cmcpartland/PID-Temperature-Controller/PID_Temperature_Controller/Pythics Gui/PID Temperature Controller/PID Temperature Controller.pdf

# PID Temperature Controller

## Arduino

- Measures temperature using thermistor
- Controls power going to heating/cooling unit (Thermo-electric cooler, TEC)
- Only variable output from Arduino is PWM signal

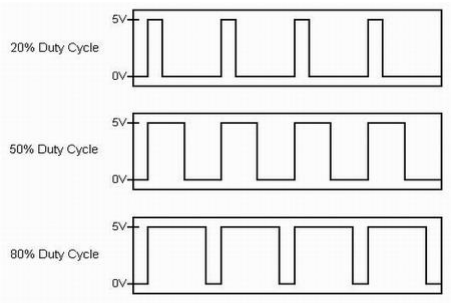
[picture p3: figure]

- Duty cycle is controllable:
- PWM:(0, 255) ⟶ Duty Cycle: (0,100)

## Circuit

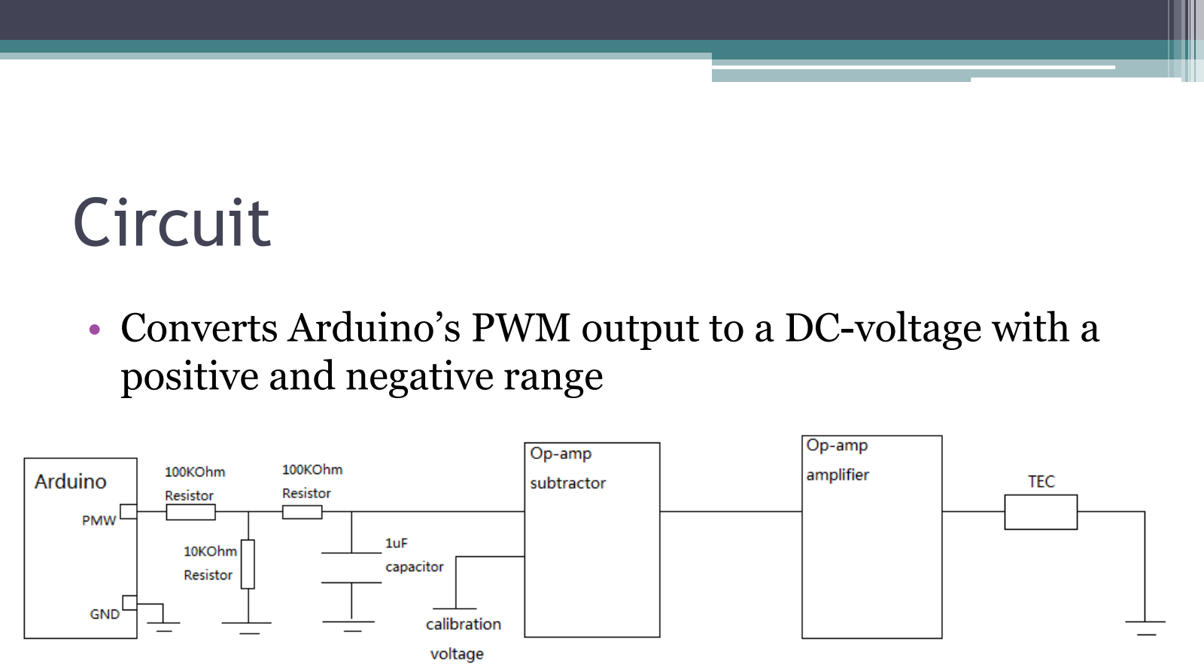
[picture p4: page 3]

- Converts Arduino’s PWM output to a DC-voltage with a positive and negative range
- Provides power for the TEC

## PID Algorithm

- Continuous:
- PWM = P ∗ error + I ∗ error dt t
0

+ D ∗

d error
dt
- Discrete:
- PWM = P ∗ error + I ∗ error ∗ Δ t + D ∗

Δerror
Δt
- Improvements:
- Handles integral windup
- Handles on-the-fly parameter changes (I term)
- Handles derivative-kick

↓ Arduino measures temperature from thermistor

↓ PID algorithm determines PWM output value

↓PWM signal converted to DC-voltage signal

↓DC-voltage signal used to power TEC

## Control Flow

## Practical Issues

- Power provided to TEC is not exactly symmetric with Arduino’s PWM output
- The larger the range, the more asymmetric the output
- Range must be large enough to properly power TEC
- Choosing a range:
- Choose a PWM range, i.e. 80 to 120
- Change calibration voltage until midpoint (PWM=100) gives 0 V output
- Make sure DC-voltage signal is symmetric,
- i.e. PWM=80 gives – 1.3 V, PWM = 120 gives 1.3 V
- Determined range: PWM: (80, 220)
- Low-end of range uses more power than high-end of range
- i.e., PWM=80 draws 1.25 A from power supply, PWM=220 draws 0.93 A

## Practical Issues (contd)

- TEC needs a good heatsink to efficiently heat and cool
- Solution:

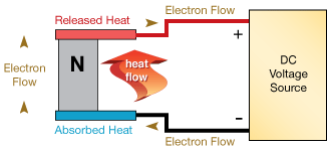
[picture p5: figure]

- Attach second TEC to open side of main TEC

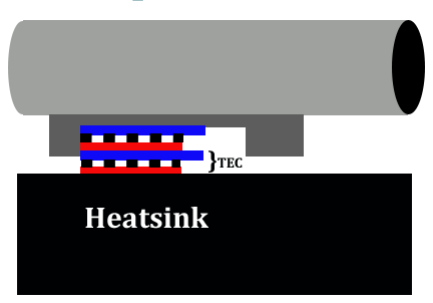
[picture p6: figure]

## Practical Issues (contd)

- Accuracy of Arduino gives error of temperature measurements: ± 0.02° C
- Measurements fall into bins of width ~0.04° C

## Temperature Controller User Interface

- Created in Pythics
- Functionality:
- Plot temperature over time
- Change parameters: P, I, D, and set-temperature
- Save parameters to Arduino’s memory

## Results

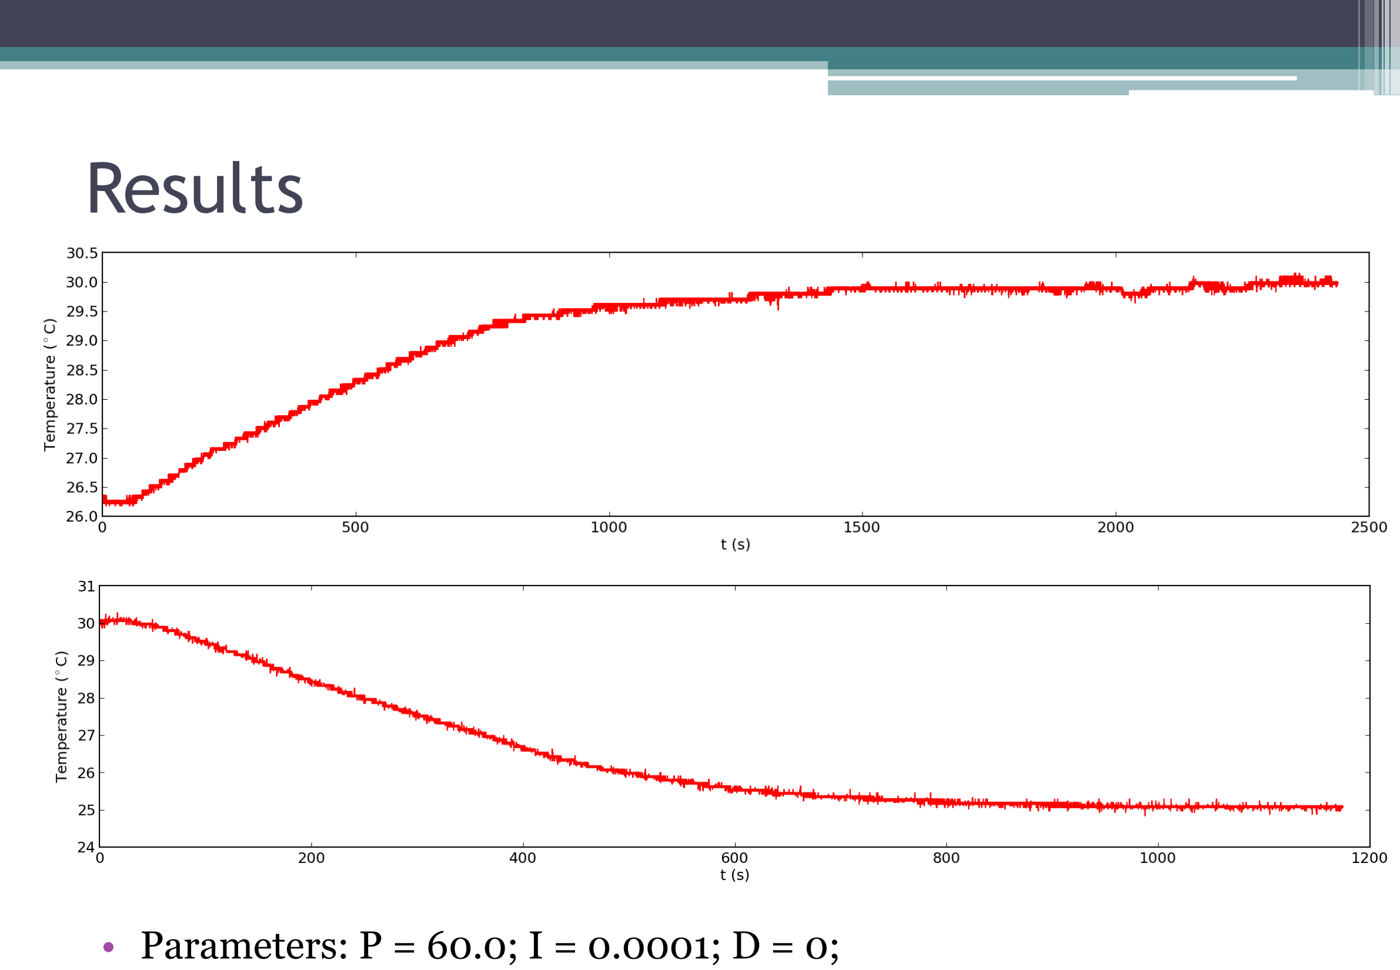
[picture p7: page 10]

- Parameters: P = 60.0; I = 0.0001; D = 0;

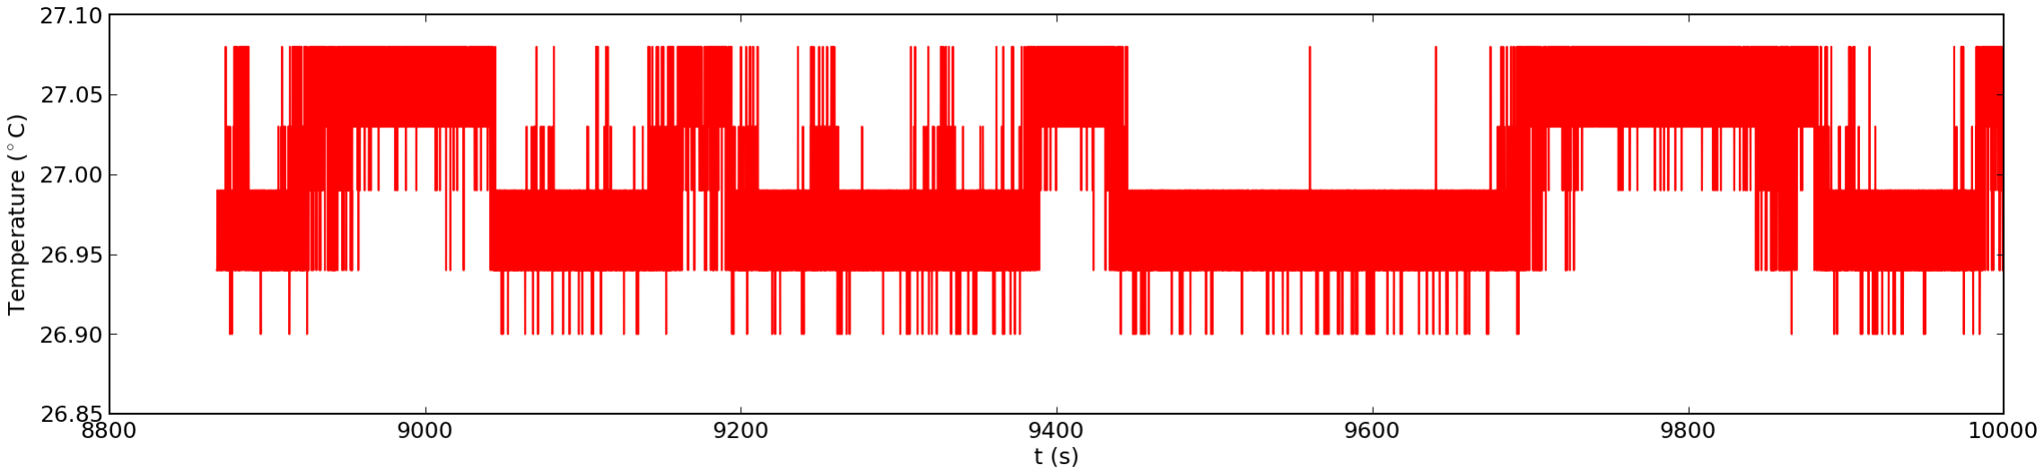
[picture p8: figure]
