cmcpartland/PID-Temperature-Controller/PID_Temperature_Controller/Pythics Gui/PID Temperature Controller/Images/device picture.jpg

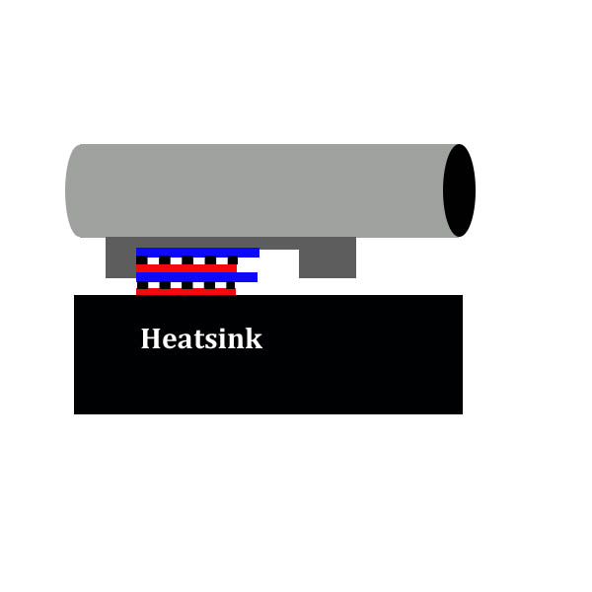
PID_Temperature_Controller/Pythics Gui/PID Temperature Controller/Images/device picture.jpg
