cmcpartland/PID-Temperature-Controller/PID_Temperature_Controller/Pythics Gui/PID Temperature Controller/Images/device picture.png

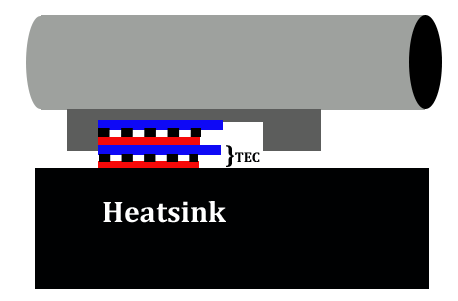
PID_Temperature_Controller/Pythics Gui/PID Temperature Controller/Images/device picture.png
