cmcpartland/PID-Temperature-Controller/PID_Temperature_Controller/Pythics Gui/PID Temperature Controller/Images/temp_ramp30to20.png

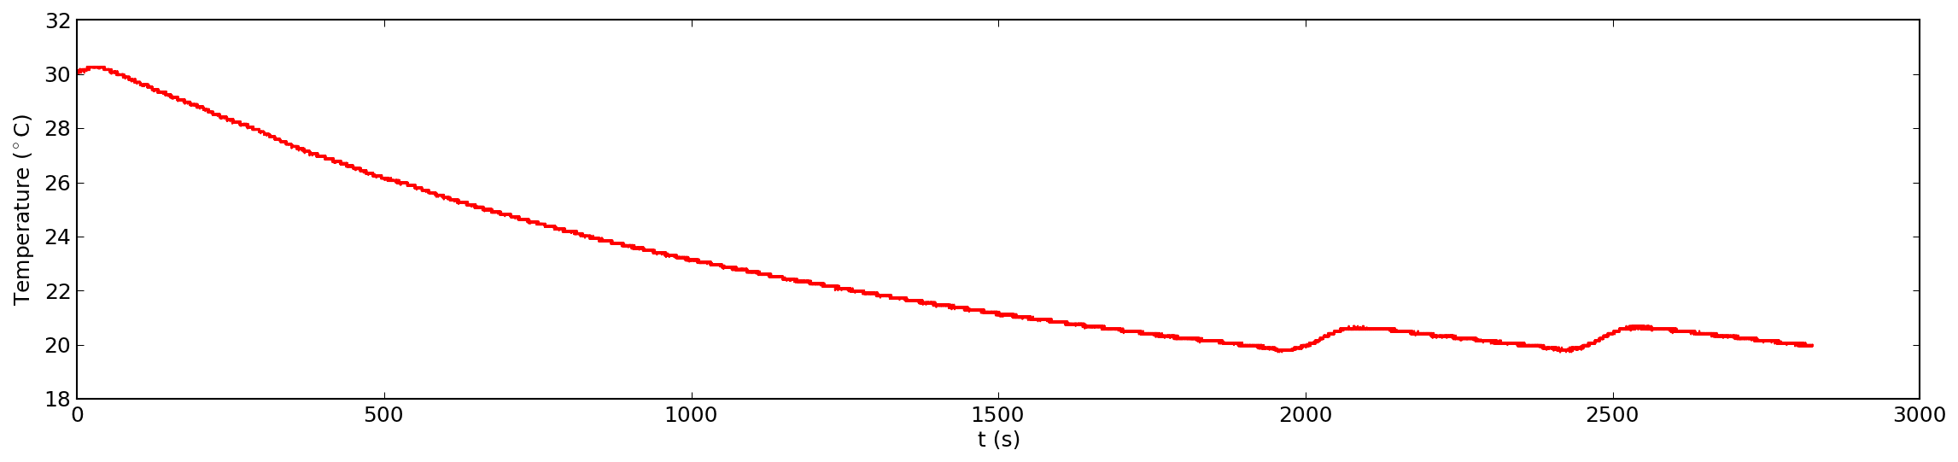
PID_Temperature_Controller/Pythics Gui/PID Temperature Controller/Images/temp_ramp30to20.png
