cmcpartland/PID-Temperature-Controller/PID_Temperature_Controller/Pythics Gui/PID Temperature Controller/Images/temp_stable down.png

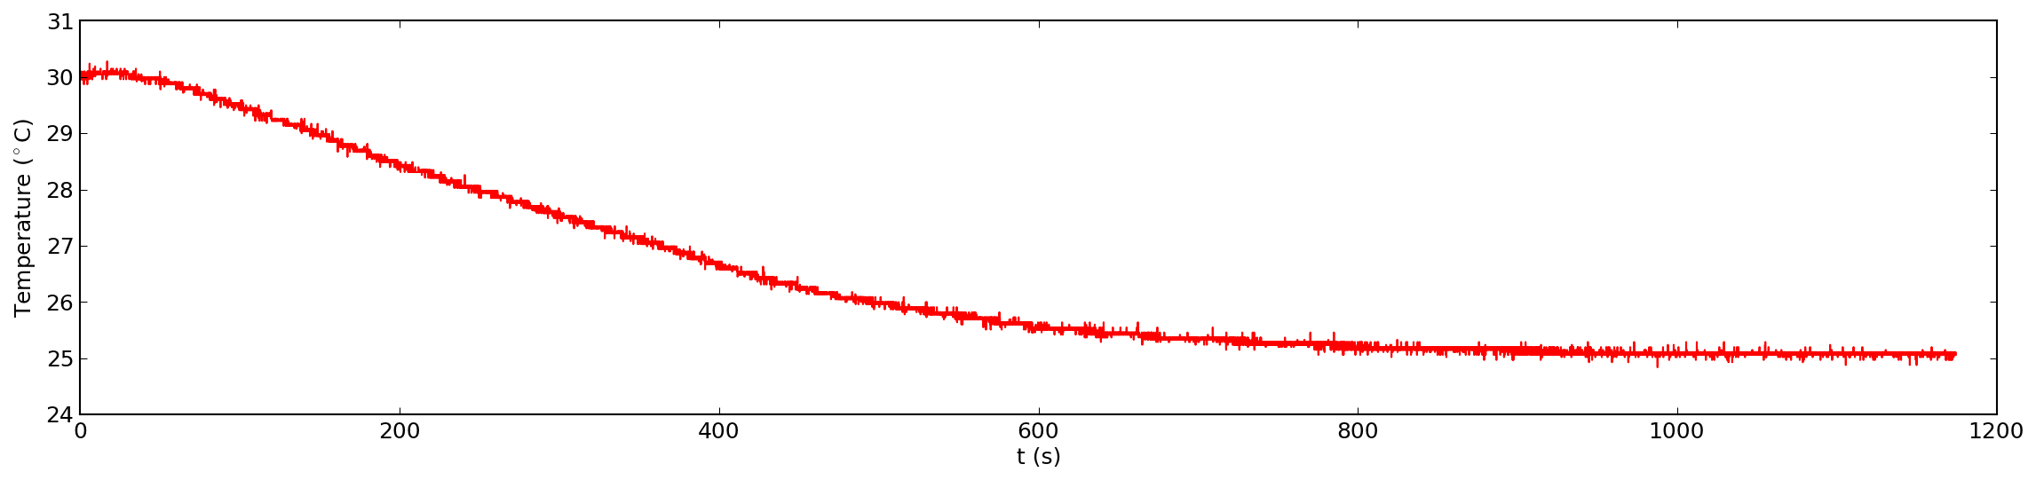
PID_Temperature_Controller/Pythics Gui/PID Temperature Controller/Images/temp_stable down.png
