cmcpartland/PID-Temperature-Controller/PID_Temperature_Controller/Pythics Gui/PID Temperature Controller/Images/temp_stable.png

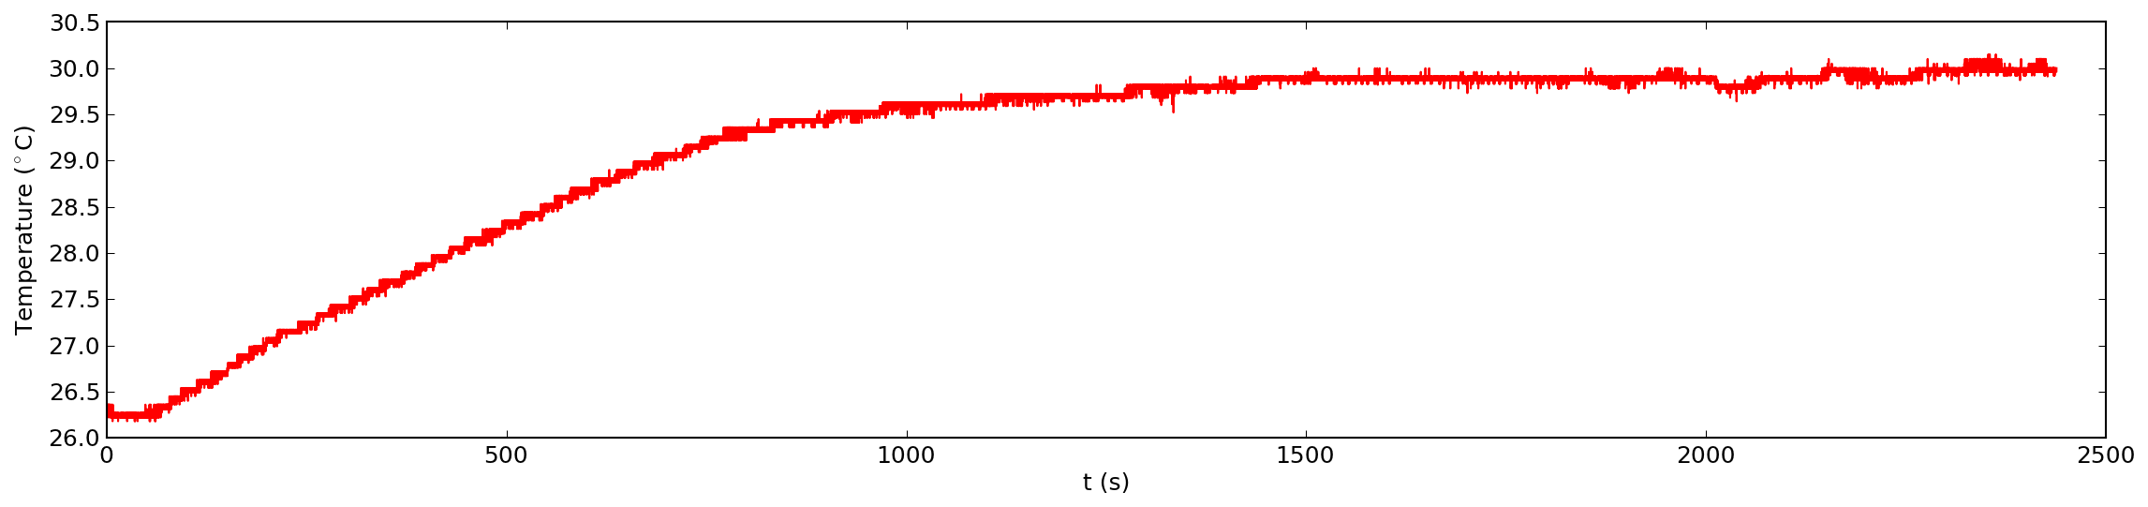
PID_Temperature_Controller/Pythics Gui/PID Temperature Controller/Images/temp_stable.png
