cmcpartland/PID-Temperature-Controller/PID_Temperature_Controller/Pythics Gui/PID Temperature Controller/Images/temp_stable_2.5Hrs.png

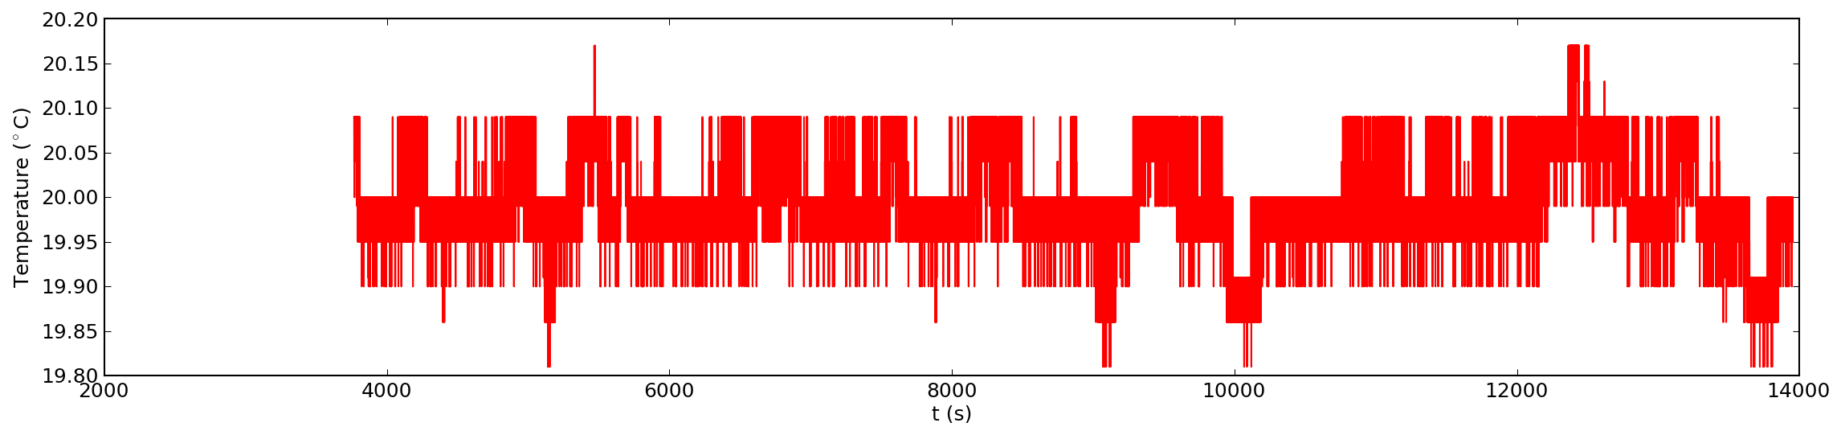
PID_Temperature_Controller/Pythics Gui/PID Temperature Controller/Images/temp_stable_2.5Hrs.png
