cmcpartland/PID-Temperature-Controller/PID_Temperature_Controller/Pythics Gui/PID Temperature Controller/PID Temperature Controller Circuit Diagram [COMPLETE].pdf

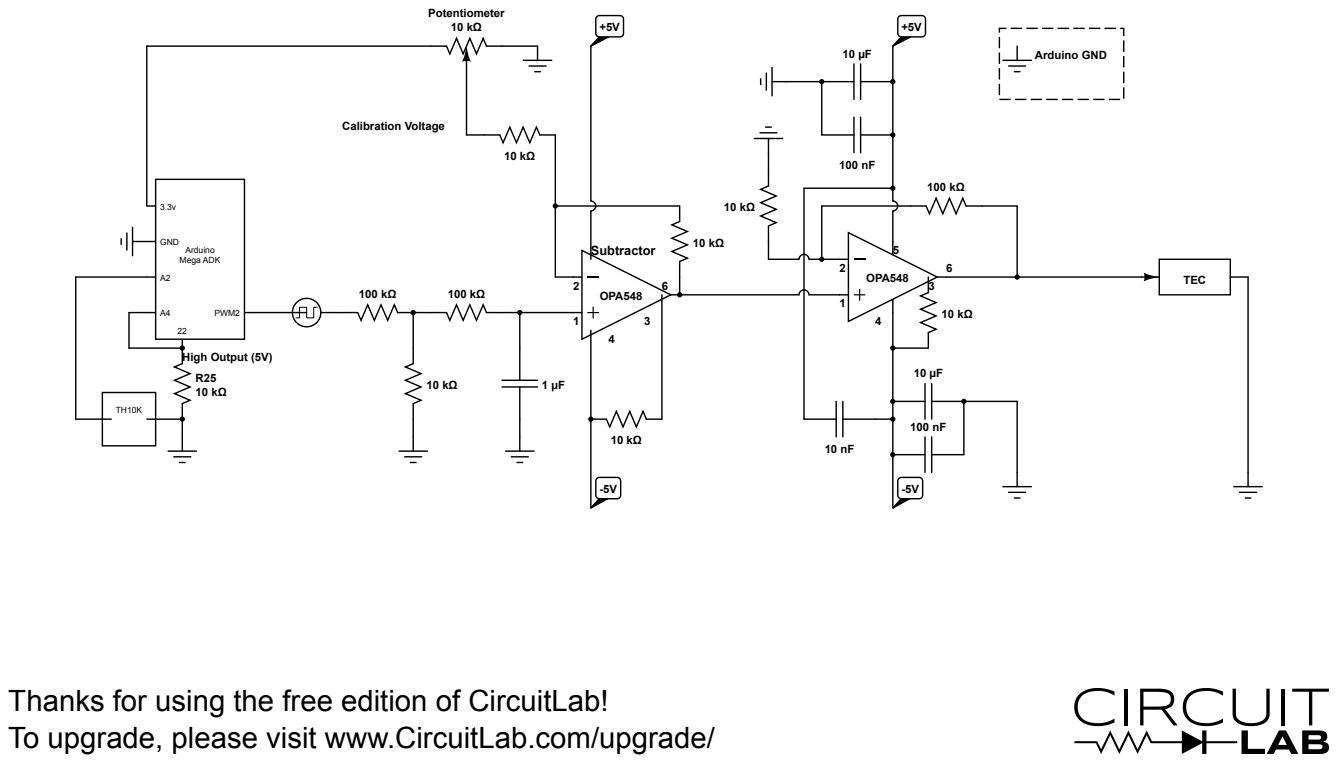
[picture p18: page 1]
Potentiometer 10 kΩ; OPA548; Arduino Mega ADK; GND; PWM2; Calibration Voltage; High Output (5V); TEC; Arduino GND; Subtractor

Thanks for using the free edition of CircuitLab!
To upgrade, please visit www.CircuitLab.com/upgrade/
